Tellzies/ChairSpeaker-CS4S-Batch2/Hardware/CS4S/Fabrication/Report Board Stack/Chairspeaker TI Receiver REV1-1.xls

Board Stack Report
Stack Up |  | Layer Stack
Layer | Board Layer Stack | Name | Material | Thickness | Constant
1 |  | Top Paste
2 |  | Top Overlay
3 |  | Top Solder | Solder Resist | 0.40mil | 3.5
4 |  | Top Layer | Copper | 0.71mil
5 |  | Dielectric1 | FR-4 | 60.79mil | 4.2
6 |  | Bot Layer | Copper | 0.71mil
7 |  | Bottom Solder | Solder Resist | 0.40mil | 3.5
8 |  | Bottom Overlay
9 |  | Bottom Paste
 | Height : 63.01mil
