Tellzies/ChairSpeaker-CS4S-Batch2/Software/doc/bone conductor eq.png

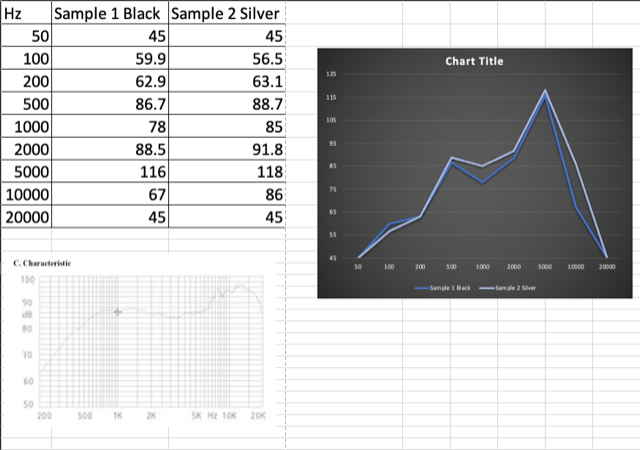
Software/doc/bone conductor eq.png
