Tellzies/ChairSpeaker-CS4S-Batch2/Hardware/CS4S/BOM/PROTO/BOM-Chairspeaker TI Receiver REV1-1_PROTO.xlsx

Quantity | Designator | Fitted | Value | Description1 | Manufacturer 1 | Manufacturer Part Number 1 | Cross Allowed
3 | BT1, J3, J4 | Fitted | 0530470210 | CONN HEADER VERT 2POS 1.25MM | Molex | 0530470210 | YES
17 | C1, C2, C7, C8, C12, C25, C30, C37, C42, C46, C48, C52, C55, C62, C69, C70, C71 | Fitted | 1uF/10V | CAP CER 1UF 10V X5R 0402 | Murata Electronics | GRM155R61A105KE15D | YES
3 | C3, C56, C57 | Fitted | 47pF/50V | CAP CER 47PF 50V C0G/NPO 0402 | Yageo | CC0402JRNPO9BN470 | YES
25 | C4, C6, C10, C13, C14, C15, C16, C17, C18, C19, C20, C22, C26, C31, C34, C35, C38, C41, C43, C45, C47, C53, C58, C59, C78 | Fitted | 0.1uF/10V | CAP CER 0.1UF 10V X7R 0402 | Yageo | CC0402KRX7R6BB104 | YES
1 | C5 | Fitted | 100uF/10V | CAP CER 100UF 10V X5R 20% 1210 | Samsung Electro-Mechanics | CL32A107MPVNNNE | YES
1 | C9 | Fitted | 18pF/50V | CAP CER 18PF 50V C0G/NP0 0402 | Samsung Electro-Mechanics | CL05C180JB5NNNC | YES
1 | C11 | Fitted | 1000pF/2KV | CAP CER 1000PF 2KV X7R 1206 | KEMET | C1206C102KGRACTU | YES
1 | C21 | Fitted | 220pF/10V | CAP CER 220PF 10V C0G/NP0 0402 | Würth Elektronik | 885012005015 | YES
3 | C23, C24, C27 | Fitted | 1nF/10V | CAP CER 10000PF 10V X7R 0402 | Yageo | CC0402KRX7R6BB103 | YES
0 | C28, C29 | Not Fitted | 1pF/50V | CAP CER 1PF 50V NP0 0402 | AVX Corporation | 04025A1R0KAT2A | YES
2 | C32, C33 | Fitted | 12pF/25V | CAP CER 12PF 25V C0G/NP0 0402 | Walsin Technology Corporation | 0402N120J250CT | YES
3 | C36, C49, C61 | Fitted | 10uF/10V | CAP CER 10UF 10V X5R 0805 | Samsung Electro-Mechanics | CL21A106KPFNNNG | YES
4 | C39, C51, C63, C68 | Fitted | 39pF/50V | CAP CER 39PF 50V C0G/NP0 0402 | Samsung Electro-Mechanics | CL05C390JB5NNNC | YES
4 | C40, C44, C64, C66 | Fitted | 330pF/50V | CAP CER 330PF 50V C0G/NP0 0402 | Walsin Technology Corporation | 0402N331J500CT | YES
0 | C50, C67 | Not Fitted | 390pF/50V | CAP CER 390PF 50V X7R 0402 | AVX Corporation | 04025C391JAT2A | YES
1 | C54 | Fitted | 6.8pF/50V | CAP CER 6.8PF 50V C0G/NP0 0402 | Samsung Electro-Mechanics | 04025A6R8KAT2A | YES
1 | C60 | Fitted | 1pF/50V | CAP CER 1PF 50V NP0 0402 | AVX Corporation | 04025A1R0KAT2A | YES
1 | C65 | Fitted | 1.8pF/50V | CAP CER 1.8PF 50V C0G/NP0 0402 | Samsung Electro-Mechanics | CL05C1R8BB5NNNC | YES
0 | C77 | Not Fitted | 0.1uF/10V | CAP CER 0.1UF 10V X7R 0402 | Yageo | CC0402KRX7R6BB104 | YES
0 | CLP1, CLP2, CLP3 | Not Fitted | S1001-46R | RFI SHIELD CLIP MICRO TIN SMD | Harwin Inc. | S1001-46R | NO
2 | D1, D3 | Fitted | SMAJ7.0CA | TVS DIODE 7VWM 12VC SMA | Littlefuse | SMAJ7.0CA | NO
2 | D2, D9 | Fitted | NSR0320MW2T3G | DIODE SCHOTTKY 20V 1A SOD323 | ON Semiconductor | NSR0320MW2T3G | NO
1 | D4 | Fitted | ESD9B5.0ST5G | TVS DIODE 5V SOD923 | ON Semiconductor | ESD9B5.0ST5G | NO
0 | D5, D10 | Not Fitted | ESD9B3.3ST5G | TVS DIODE 3.3V 11.5V SOD923 | ON Semiconductor | ESD9B3.3ST5G | YES
0 | D6, D7, D11 | Not Fitted | GG0402050R3C2P | TVS DIODE 5V 15.5V 0402 | AVX Corporation | GG0402050R3C2P | YES
0 | D8 | Not Fitted | NSR0320MW2T3G | DIODE SCHOTTKY 20V 1A SOD323 | ON Semiconductor | NSR0320MW2T3G | NO
0 | DM1 | Not Fitted | DM-SHIELD | TBD | TBD | TBD | NO
3 | FB1, FB2, FB3 | Fitted | BK1005HS102-T | FERRITE BEAD 1 KOHM 0402 1LN | Taiyo Yuden | BK1005HS102-T | YES
1 | J1 | Fitted | ZX62-B-5PA(33) | CONN RCPT MICRO USB B SMD R/A | Hirose | ZX62-B-5PA(33) | YES
0 | J5 | Not Fitted | HDR_1X2 | CONN HEADER VERT 2POS 2.54MM | Harwin Inc. | M20-9990246 | YES
1 | L1 | Fitted | MPZ1608S300ATAH0 | FERRITE BEAD 30 OHM 0603 1LN | TDK Corporation | MPZ1608S300ATAH0 | YES
9 | L2, L3, L7, L8, L9, L10, L11, L12, L14 | Fitted | 6.8nH | FIXED IND 6.8NH 430MA 250 MOHM | Taiyo Yuden | HK10056N8J-T | YES
1 | L4 | Fitted | 2.2nH | FIXED IND 2.2NH 900MA 120MOHM SM | Murata Electronics | LQG15HS2N2S02D | YES
1 | L5 | Fitted | 3nH | FIXED IND 3NH 800MA 125 MOHM SMD | Murata Electronics | LQG15HS3N0S02D | YES
1 | L6 | Fitted | 3.9nH | FIXED IND 3.9NH 750MA 180MOHM SM | Murata Electronics | LQG15HS3N9S02D | YES
3 | L13, L15, L16 | Fitted | BLM18PG121SN1D | FERRITE BEAD 120 OHM 0603 1LN | Murata | BLM18PG121SN1D | YES
1 | L17 | Fitted | 1.5nH | FIXED IND 1.5NH 1A 100 MOHM SMD | Murata Electronics | LQG15HS1N5S02D | YES
2 | LED1, LED2 | Fitted | LTST-C193TBKT-5A | LED BLUE CLEAR CHIP 0603 SMD | LITEON | LTST-C193TBKT-5A | YES
0 | P1 | Not Fitted | TC2050-IDC-NL | PROGRAMMING CABLE PLUG-OF-NAILS | TAG-CONNECT | TC2050-IDC-NL | NO
8 | R1, R4, R10, R13, R18, R27, R33, R43 | Fitted | 10K | RES 10K OHM 1% 1/16W 0402 | Stackpole Electronics Inc | RMCF0402FT10K0 | YES
0 | R2, R7 | Not Fitted | 0R/1.5W | RES SMD 0 OHM JUMPER 1.5W 2512 | Vishay Dale | CRCW25120000Z0EGHP | YES
8 | R3, R6, R29, R30, R32, R38, R40, R42 | Fitted | 0R | RES 0R JUMPER 1/10W 0402 | Panasonic Electronic Components | ERJ-2GE0R00X | YES
1 | R5 | Fitted | 2K | RES SMD 2K OHM 1% 1/10W 0402 | Panasonic | ERJ-2RKF2001X | YES
0 | R8, R9, R15 | Not Fitted | 0R | RES 0R JUMPER 1/10W 0402 | Panasonic Electronic Components | ERJ-2GE0R00X | YES
1 | R11 | Fitted | 4.3K | RES 4.3K OHM 1% 1/10W 0402 | KOA Speer Electronics, Inc. | RK73H1ETTP4301F | YES
0 | R12, R20, R35, R45 | Not Fitted | 10K | RES 10K OHM 1% 1/16W 0402 | Stackpole Electronics Inc | RMCF0402FT10K0 | YES
1 | R14 | Fitted | 1M | RES SMD 1M OHM 1% 1/10W 0402 | Panasonic | ERJ-2RKF1004X | YES
1 | R17 | Fitted | 56K | RES 56K OHM 1% 1/16W 0402 | Stackpole Electronics Inc | RMCF0402FT56K0 | YES
1 | R19 | Fitted | 100K | RES 100K OHM 1% 1/16W 0402 | Stackpole Electronics Inc | RMCF0402FT100K | YES
1 | R21 | Fitted | 470R | RES 470 OHM 1% 1/16W 0402 | Stackpole Electronics Inc | RMCF0402FT470R | YES
1 | R22 | Fitted | 220R | RES 220 OHM 1% 1/16W 0402 | Stackpole Electronics Inc | RMCF0402FT220R | YES
4 | R28, R31, R39, R41 | Fitted | 30K | RES SMD 30K OHM 1% 1/10W 0402 | Panasonic Electronic Components | ERJ-2RKF3002X | YES
2 | R34, R44 | Fitted | 1K | RES 1K OHM 1% 1/16W 0402 | Stackpole Electronics Inc | RMCF0402FT1K00 | YES
2 | R36, R37 | Fitted | 4.7K | RES 4.7K OHM 1% 1/16W 0402 | Stackpole Electronics Inc | RMCF0402FT4K70 | YES
1 | S1 | Fitted | RV0971GS | Potentiometer |  | RV0971GS | YES
1 | SW1 | Fitted | PTS645-V-L58-2-LFS | SWITCH TACTILE SPST-NO 0.05A 12V | C&K | PTS645-V-L58-2-LFS | YES
1 | U1 | Fitted | BU33SD5WG-TR | IC REG LINEAR 3.3V 500MA 5SSOP | Rohm Semiconductor | BU33SD5WG-TR | NO
1 | U2 | Fitted | MCP73812T-420I/OT | CHARGER IC LI-ION/LI-POLY SOT23-5 | MICROCHIP | MCP73812T-420I/OT | NO
1 | U3 | Fitted | CC8530RHAT | RF Transceiver PurePath Wireless 2.4GHz RF SoC | Texas Instruments | CC8530RHAT | NO
0 | U4 | Not Fitted | PESD3V3L5UY,115 | TVS DIODE 3.3V 12V 6TSSOP | Nexperia USA Inc. | PESD3V3L5UY,115 | NO
2 | U5, U7 | Fitted | NS4150 | Low EMI,Filterless,3W Mono Class D Audio Amplifier, Low EMI,Filterless,3W Mono Class D Audio Amplifier,SOP-8 | NSIWAY | NS4150 | NO
1 | U6 | Fitted | TLV320DAC32IRHBR | IC DAC 24BIT 96K 32VQFN | Texas Instruments | TLV320DAC32IRHBR | NO
1 | U8 | Fitted | Value | IC RF FRONT END 2.4GHZ 16-QFN
1 | X1 | Fitted | 48MHz | CRYSTAL 48.0000MHZ 10PF SMD | ECS Inc. | ECS-480-10-36B-CKM-TR | NO
