Tellzies/ChairSpeaker-CS4S-Batch2/Hardware/CS4S/DOCUMENTATION/PROTO/Chairspeaker TI Receiver REV1-1 Schematic 2022-04-20.PDF

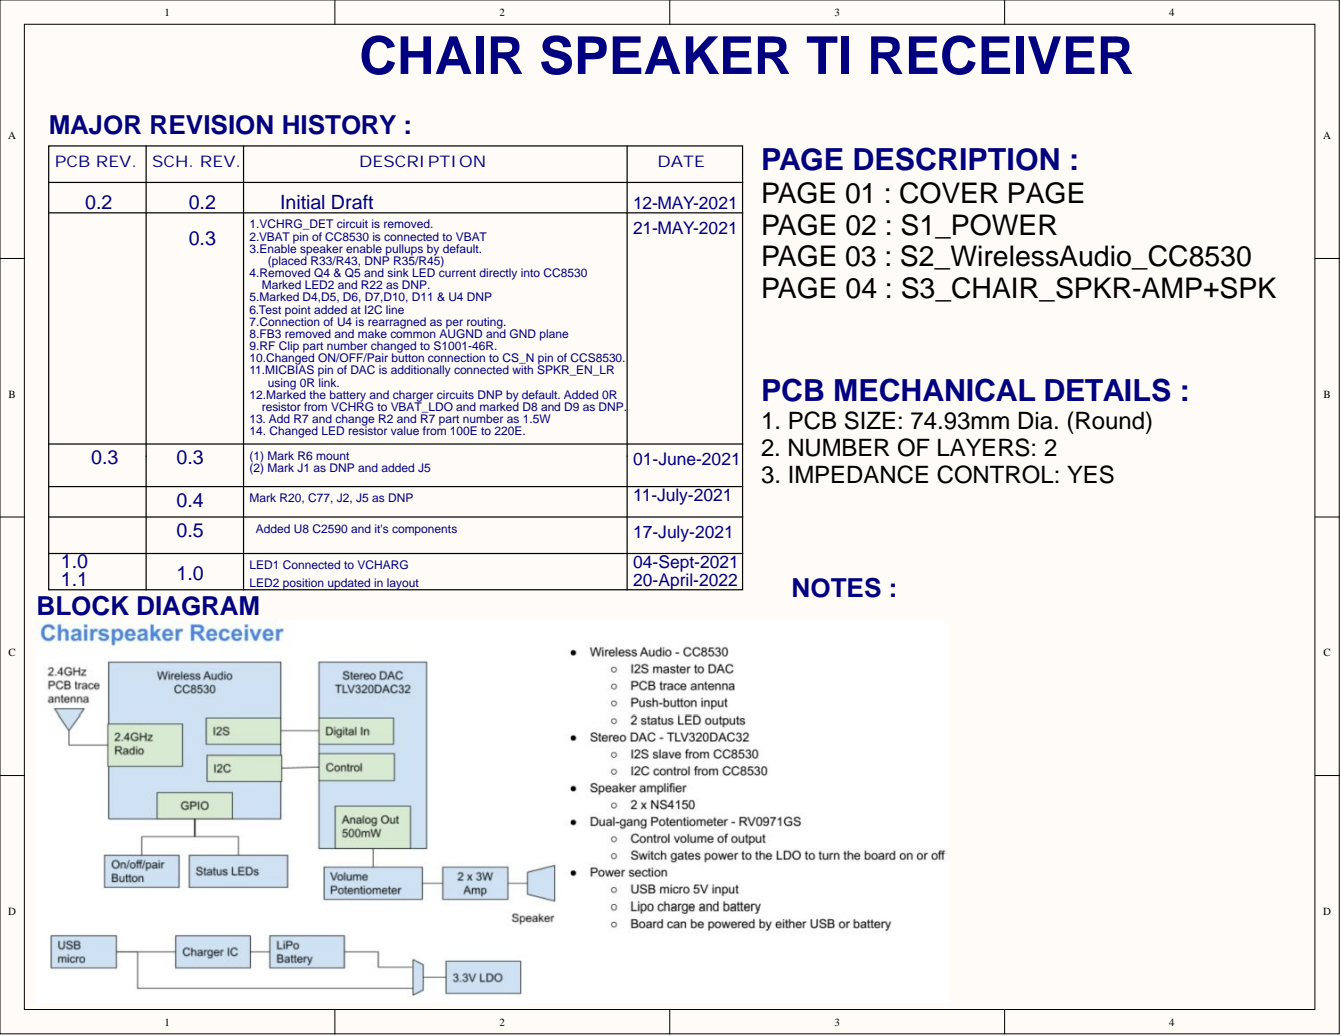
[picture p2: page 1]

CHAIR SPEAKER TI RECEIVER

PCB REV. | SCH. REV. | DESCRIPTION | DATE

0.2 | | Initial Draft | 12-MAY-2021

2.VBAT pin of CC8530 is connected to VBAT
3.Enable speaker enable pullups by default.
(placed R33/R43, DNP R35/R45)
4.Removed Q4 & Q5 and sink LED current directly into CC8530
Marked LED2 and R22 as DNP.
5.Marked D4,D5, D6, D7,D10, D11 & U4 DNP
6.Test point added at I2C line
7.Connection of U4 is rearragned as per routing.
8.FB3 removed and make common AUGND and GND plane
9.RF Clip part number changed to S1001-46R.
10.Changed ON/OFF/Pair button connection to CS_N pin of CCS8530.
11.MICBIAS pin of DAC is additionally connected with SPKR_EN_LR
using 0R link.
12.Marked the battery and charger circuits DNP by default. Added 0R
resistor from VCHRG to VBAT_LDO and marked D8 and D9 as DNP.
13. Add R7 and change R2 and R7 part number as 1.5W
14. Changed LED resistor value from 100E to 220E.

PCB MECHANICAL DETAILS :
1. PCB SIZE: 74.93mm Dia. (Round)
2. NUMBER OF LAYERS: 2
3. IMPEDANCE CONTROL: YES

0.3 | 0.3 | (2) Mark J1 as DNP and added J5 | 01-June-2021 (1) Mark R6 mount

0.4 | Mark R20, C77, J2, J5 as DNP | 11-July-2021

0.5 | | 17-July-2021 Added U8 C2590 and it's components

1.1 | 1.0 | LED1 Connected to VCHARG LED2 position updated in layout | 04-Sept-2021 20-April-2022

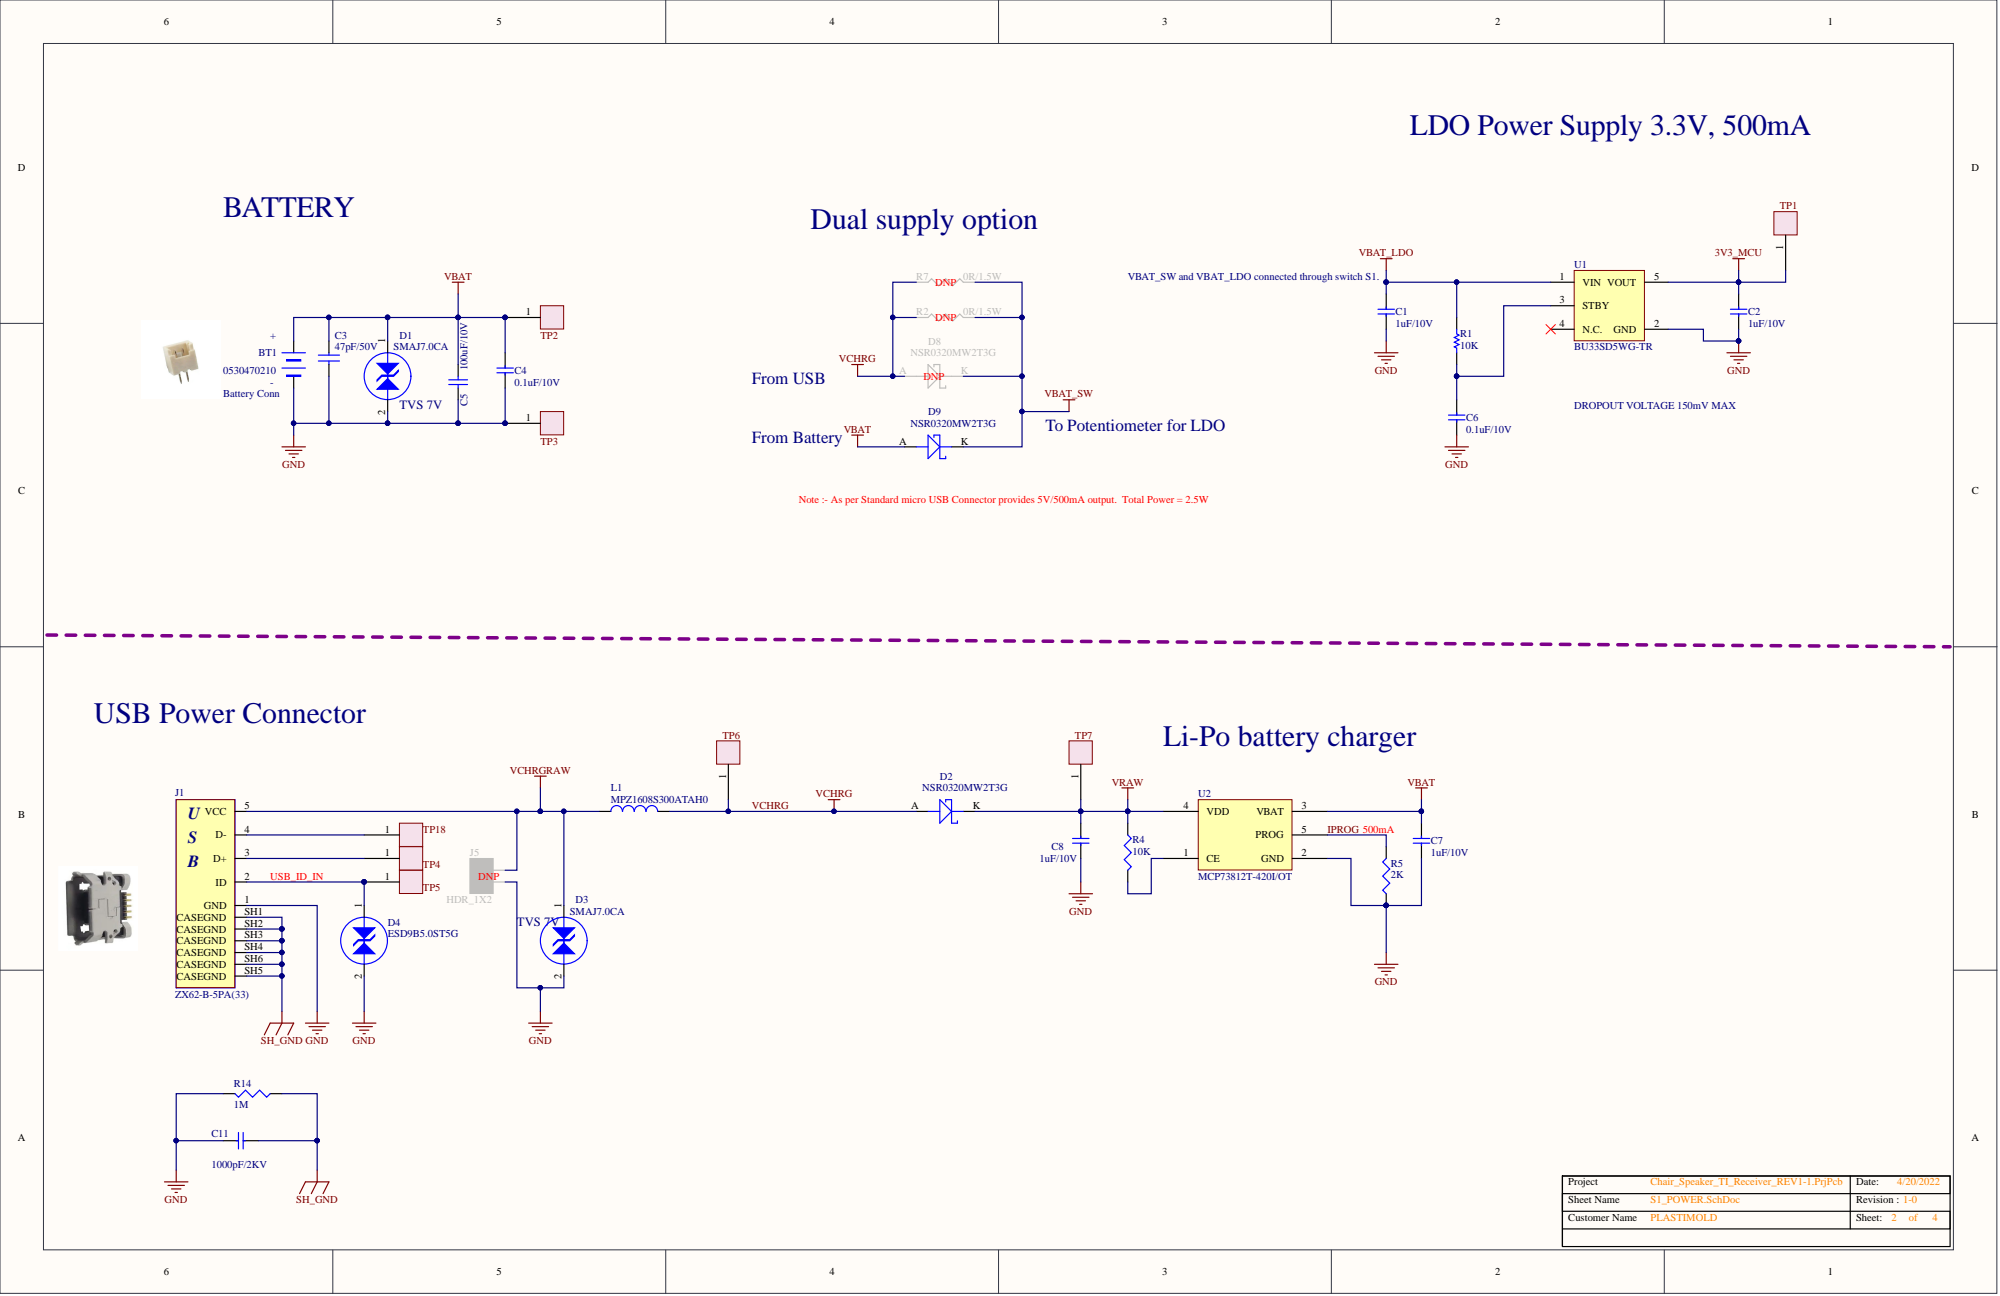
[picture p3: page 2]

VBAT_SW and VBAT_LDO connected through switch S1.

C3 | D1 SMAJ7.0CA

VBAT_SW
To Potentiometer for LDO

Note :- As per Standard micro USB Connector provides 5V/500mA output. Total Power = 2.5W

Li-Po battery charger

Project Chair_Speaker_TI_Receiver_REV1-1.PrjPcb | Date: 4/20/2022
Sheet Name S1_POWER.SchDoc | Revision :
Customer Name PLASTIMOLD | Sheet: 2 of 4

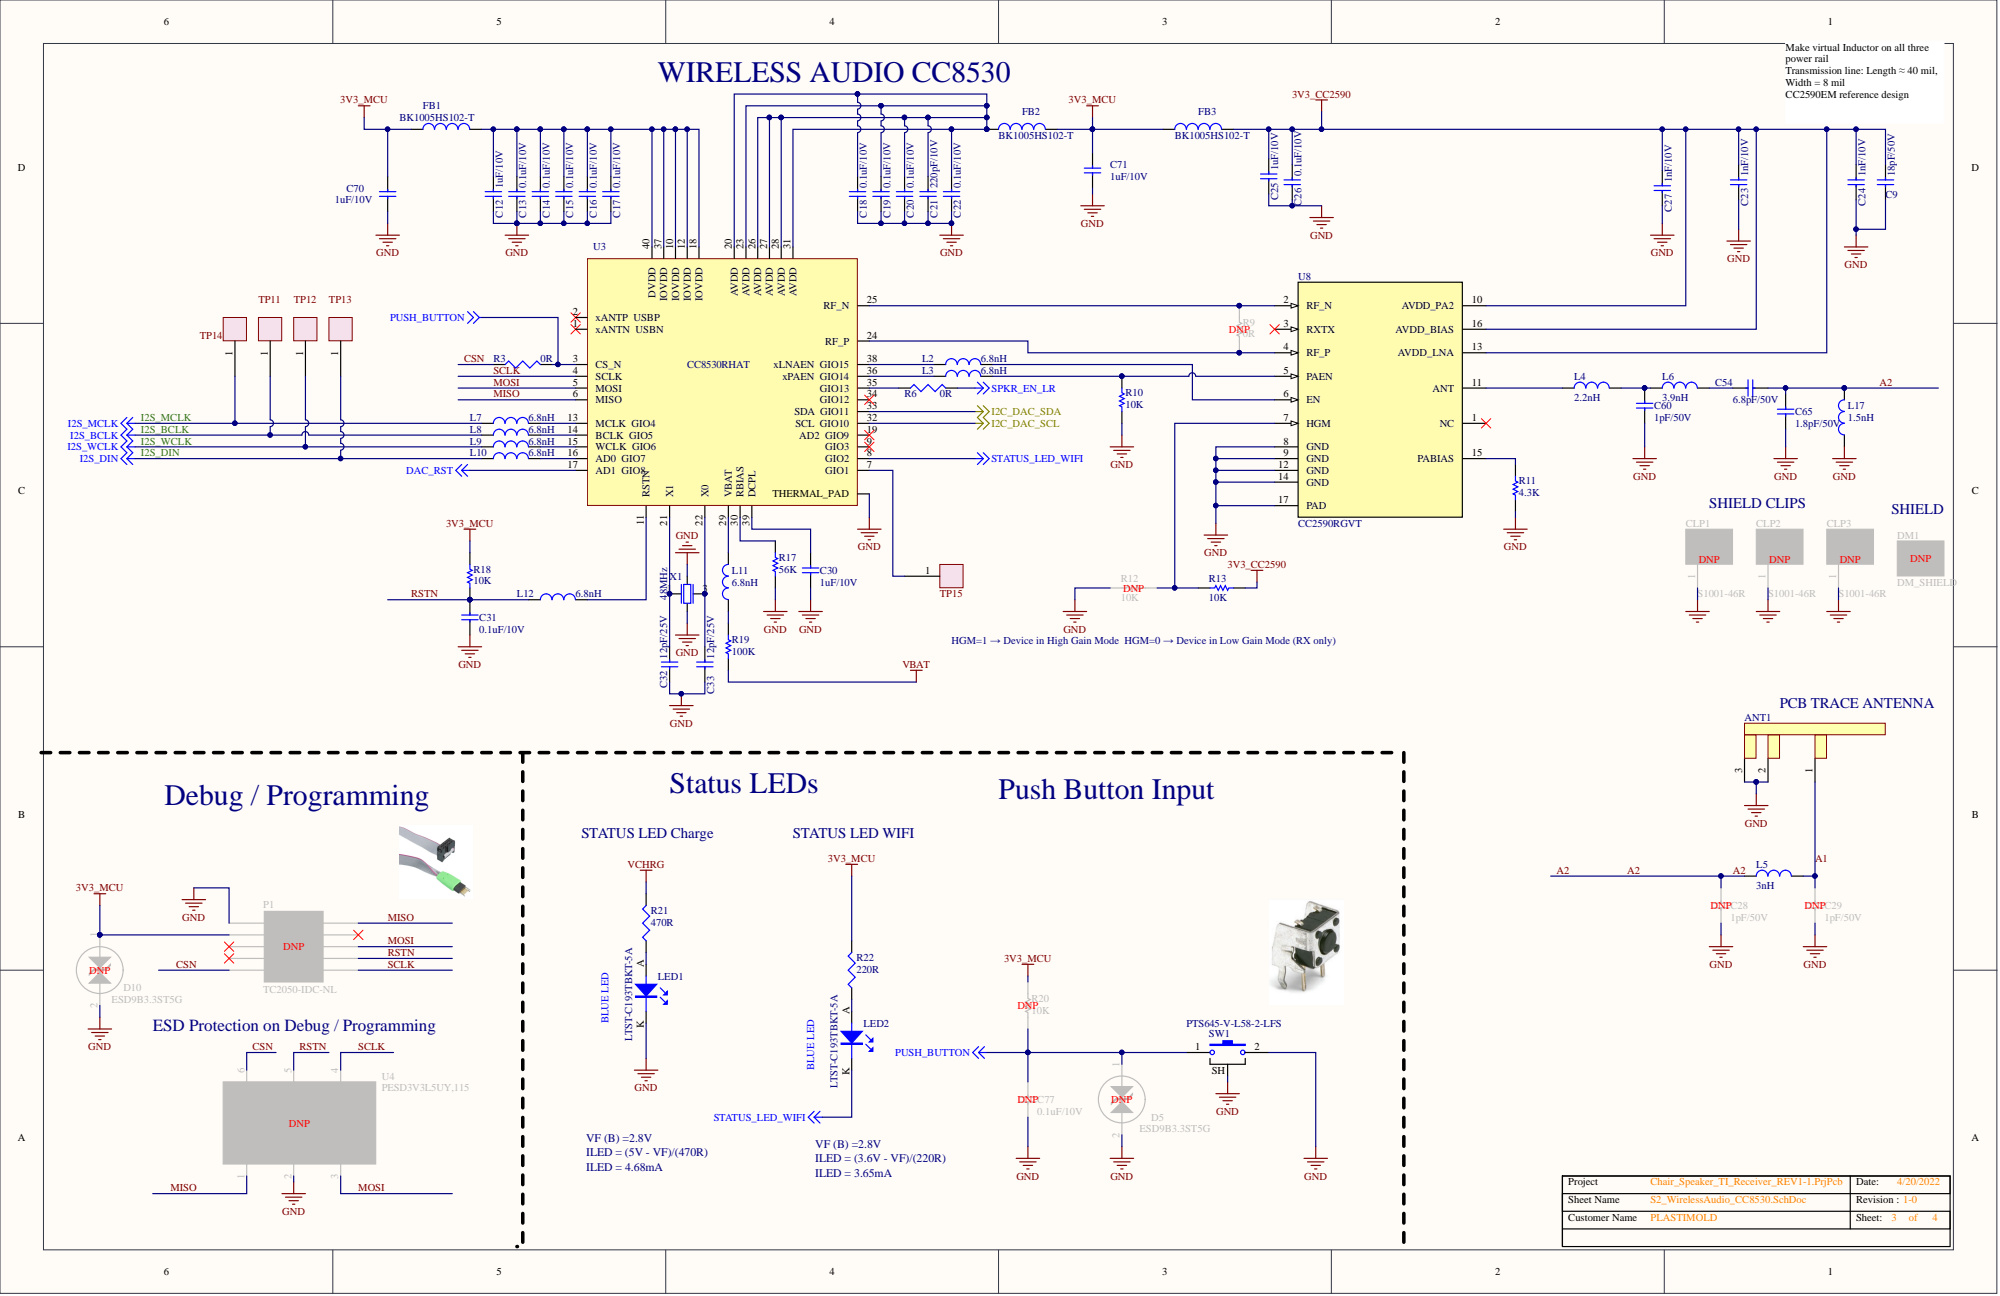
[picture p4: page 3]

Make virtual Inductor on all three
power rail
Transmission line: Length ≈ 40 mil,
Width = 8 mil
CC2590EM reference design

AVDD 31 SCL GIO10 32 SDA GIO11 33 GIO12 34 GIO13 35 xPAEN GIO14 36

GND 8

GND 12
GND 14

PAD 17

GND 1 | 3

HGM=1 → Device in High Gain Mode HGM=0 → Device in Low Gain Mode (RX only)

S2_WirelessAudio_CC8530.SchDoc
PLASTIMOLD | Sheet: 3 of 4

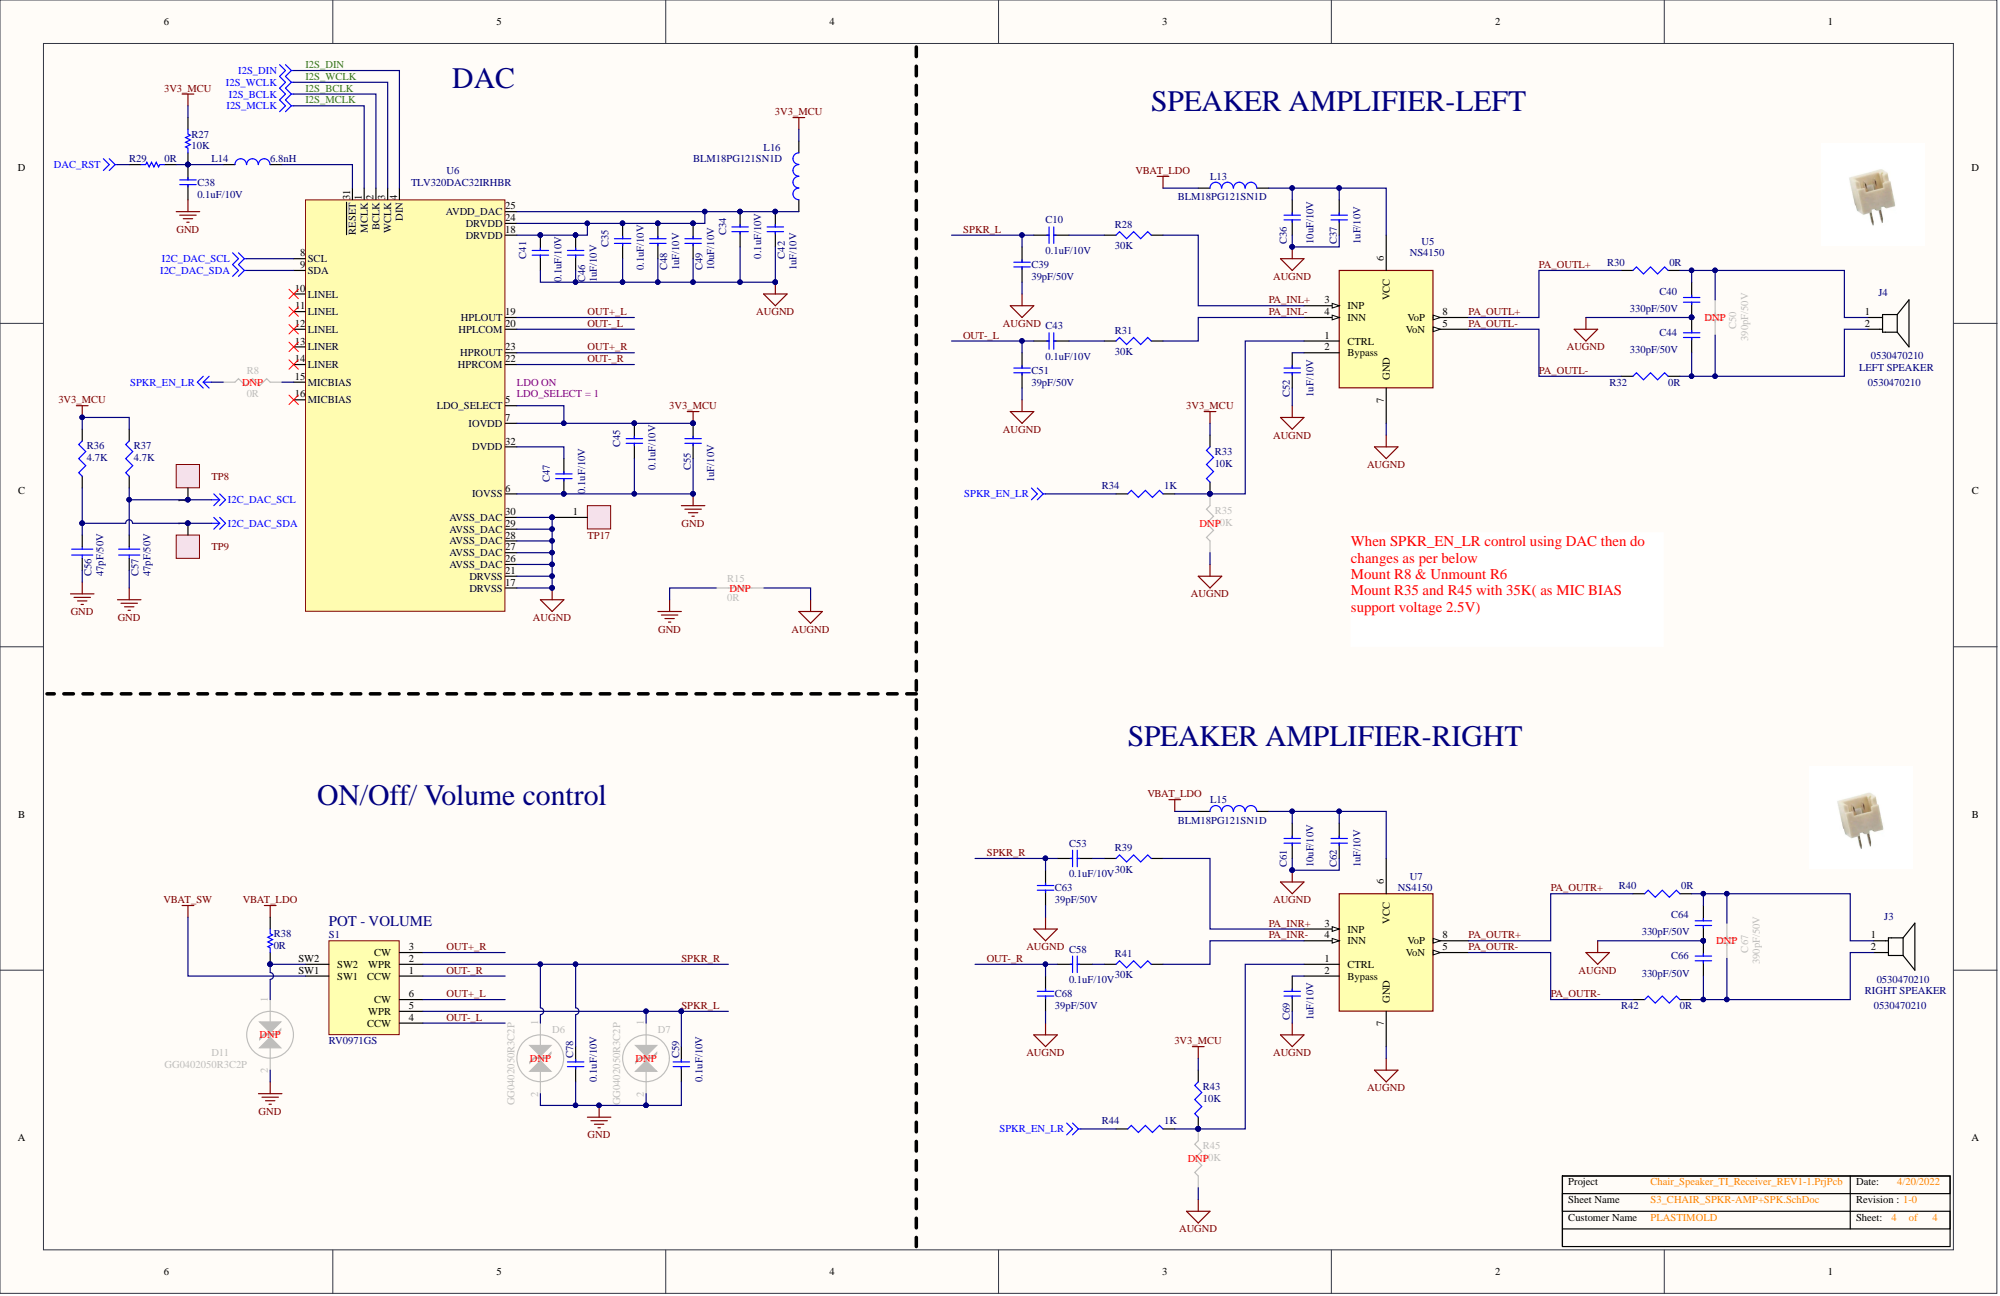
[picture p5: page 4]

When SPKR_EN_LR control using DAC then do
changes as per below
Mount R8 & Unmount R6
Mount R35 and R45 with 35K( as MIC BIAS
support voltage 2.5V)

ON/Off/ Volume control

Project Chair_Speaker_TI_Receiver_REV1-1.PrjPcb | Date: 4/20/2022

S3_CHAIR_SPKR-AMP+SPK.SchDoc
PLASTIMOLD | Sheet: 4 of 4
