Tellzies/ChairSpeaker-CS4S-Batch2/Hardware/CS4S/DOCUMENTATION/PROTO/Chairspeaker TI Receiver REV1-1 Assembly 2022-04-20.PDF

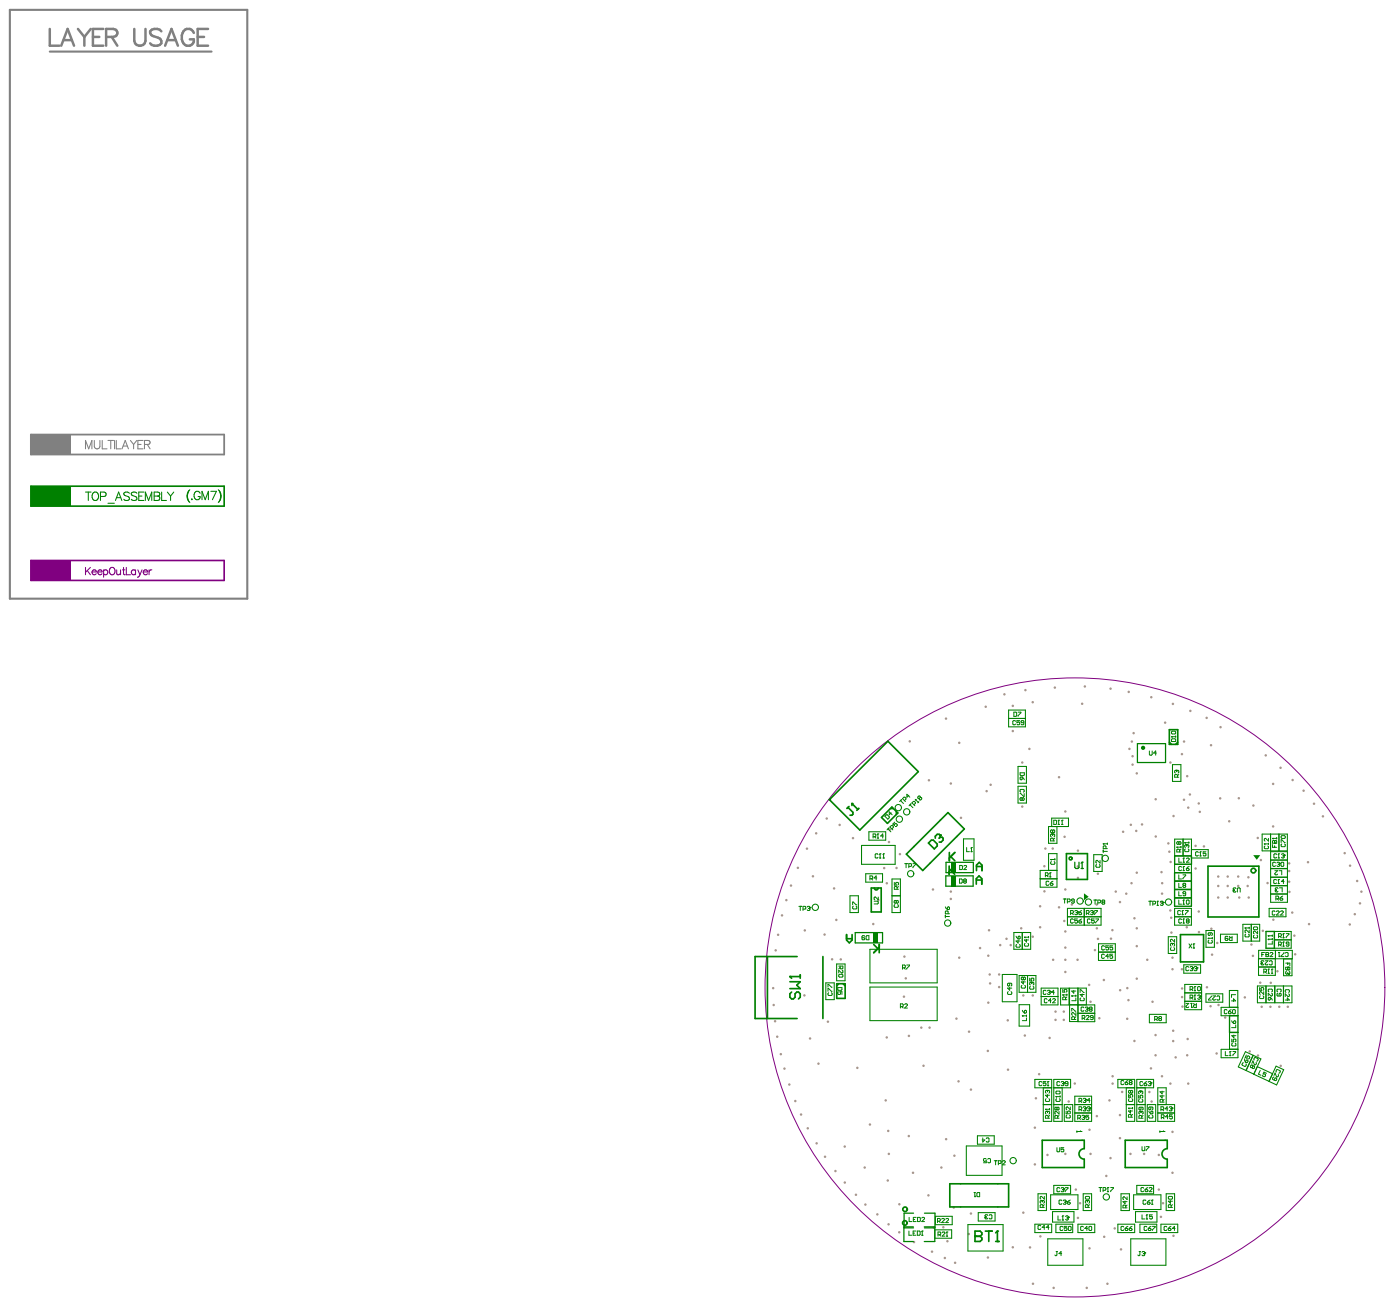
[picture p6: page 1]

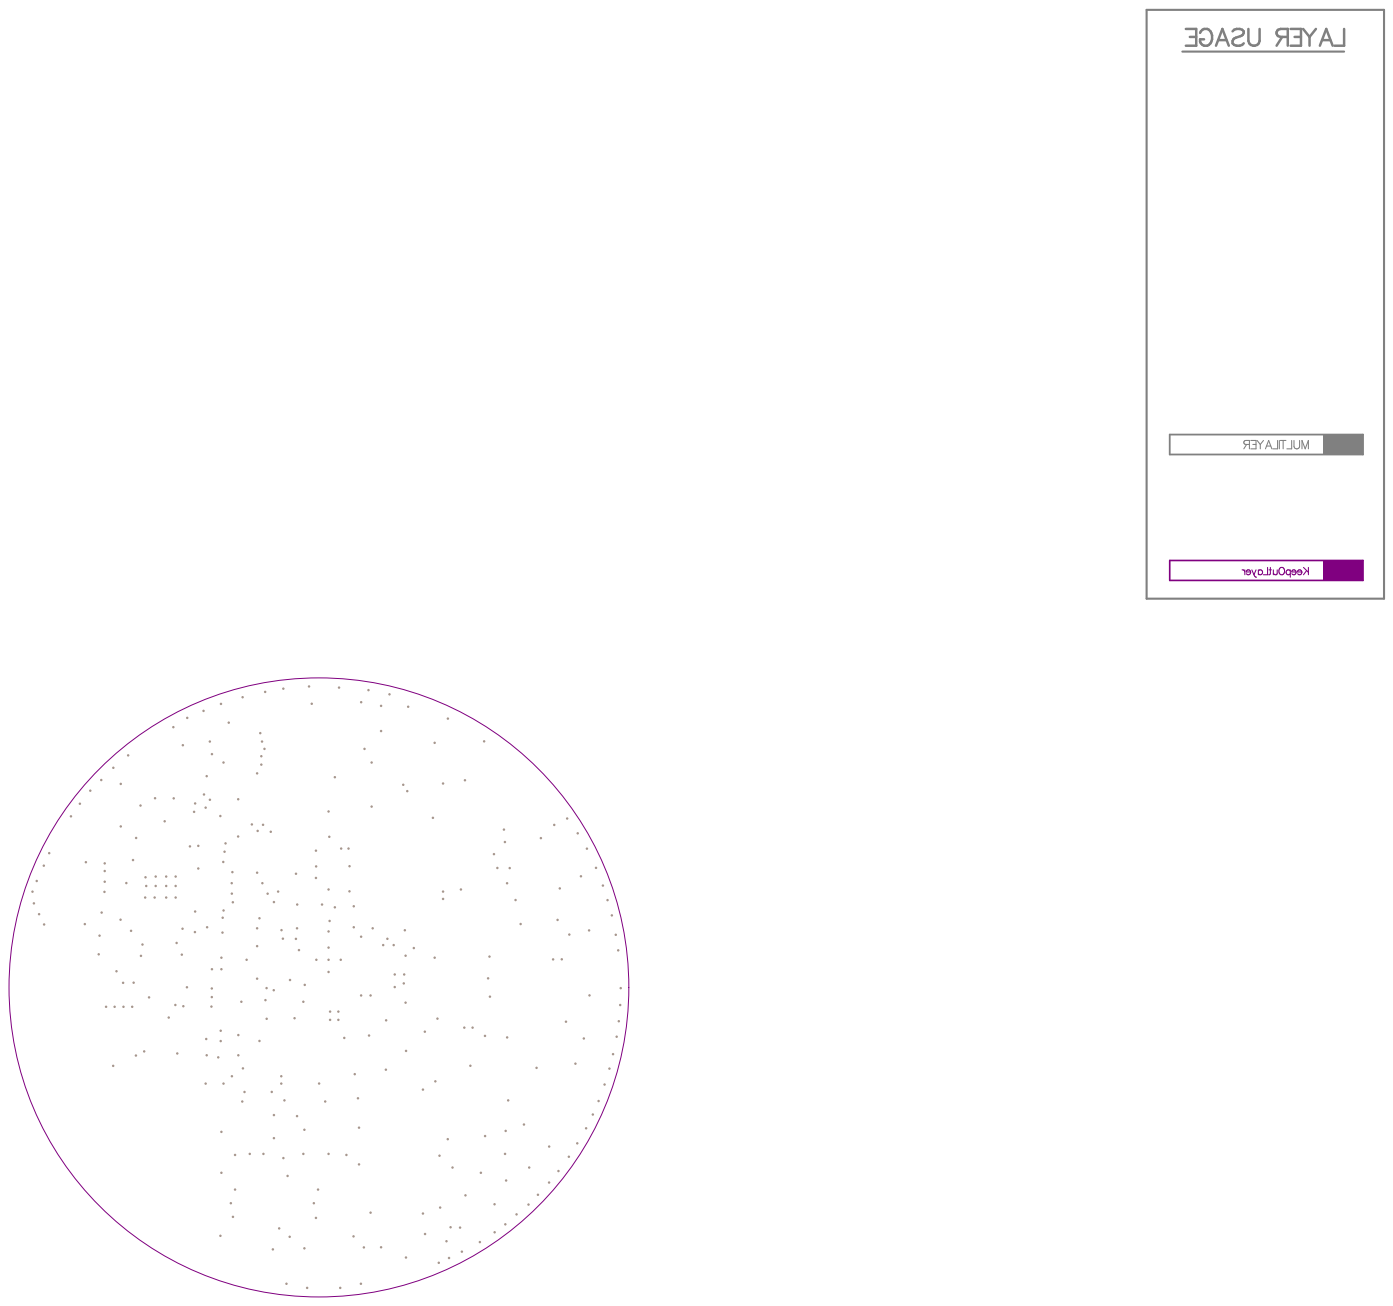
[picture p7: page 2]
