Tellzies/ChairSpeaker-CS4S-Batch2/Hardware/CS4S/DOCUMENTATION/PROTO/Chairspeaker TI Receiver REV1-1 Layout 2022-04-20.PDF

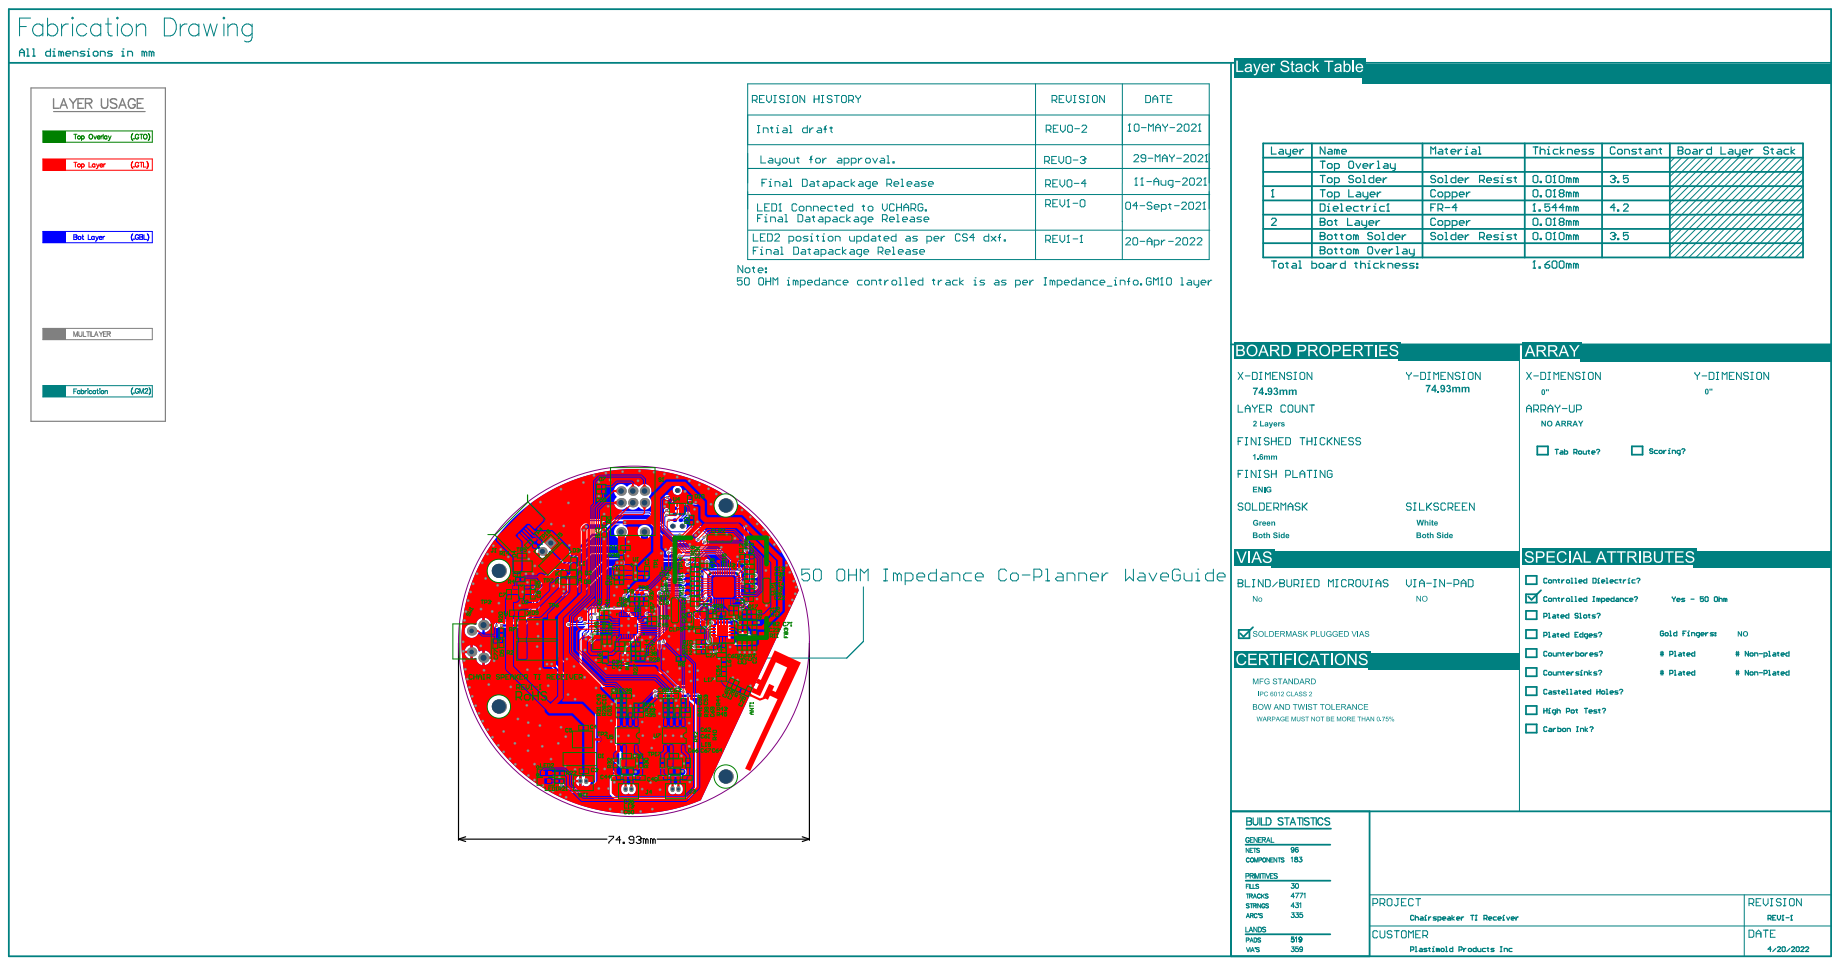
[picture p8: page 1]

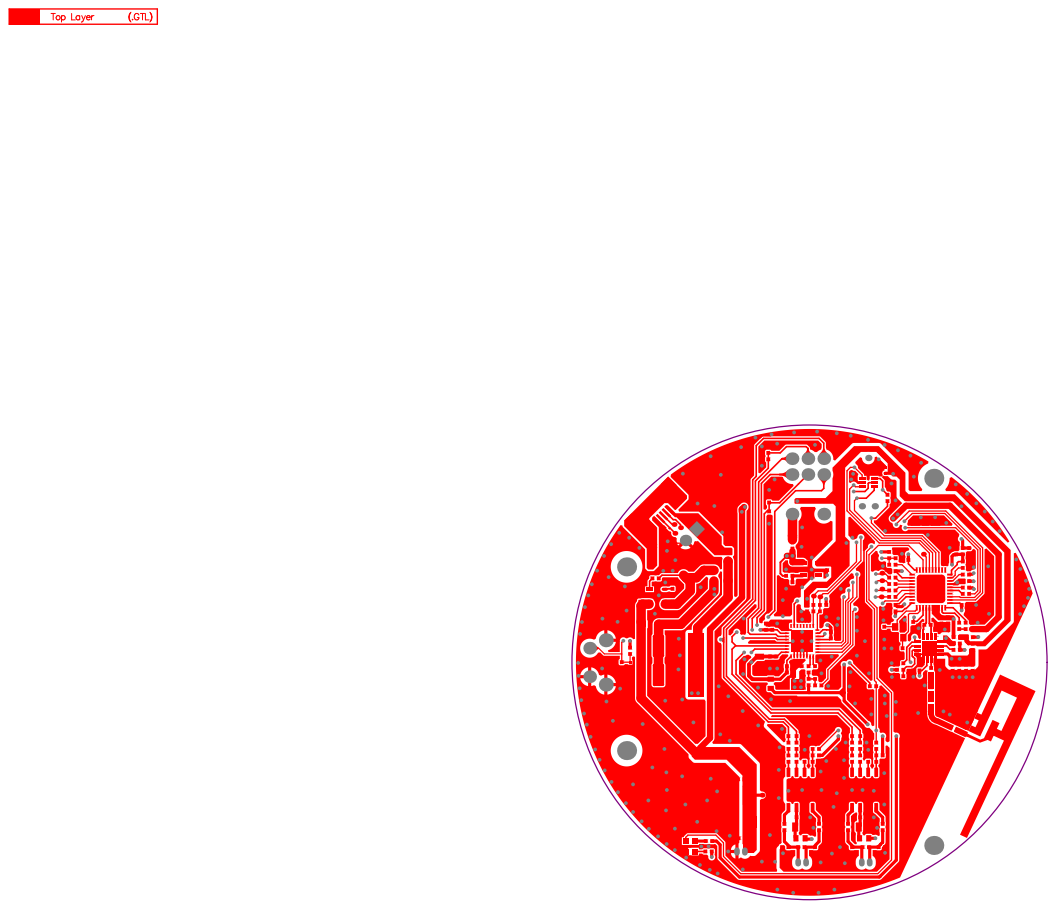
[picture p9: page 2]

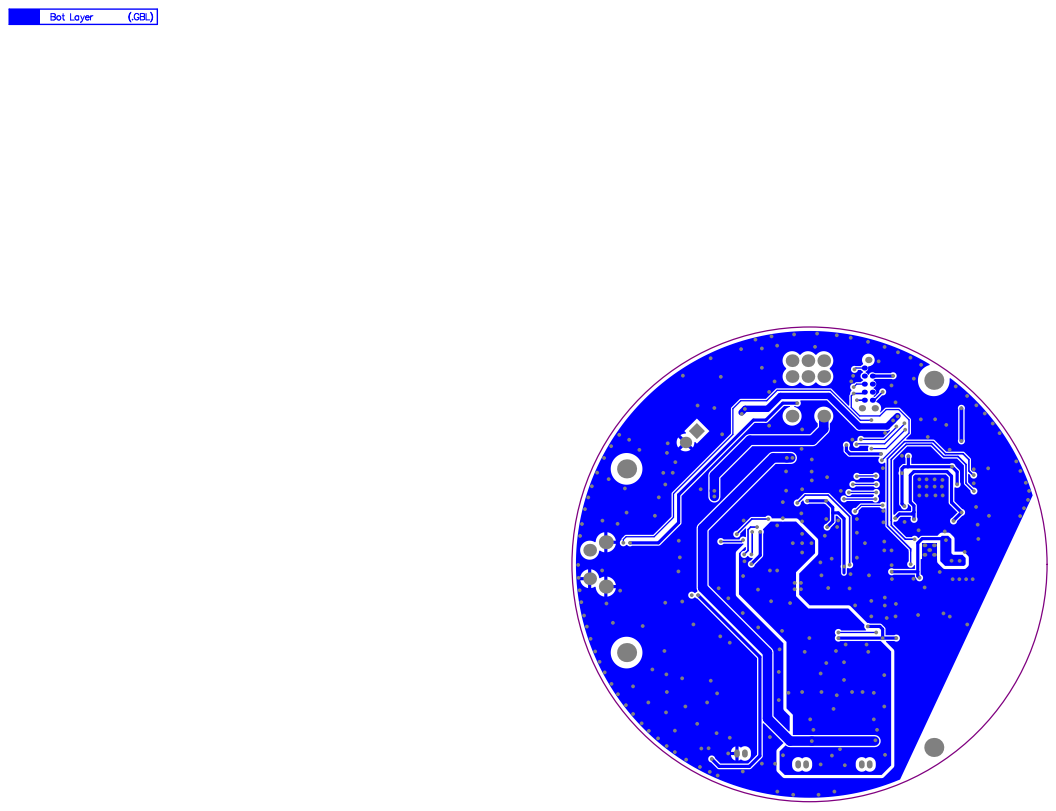
[picture p10: page 5]

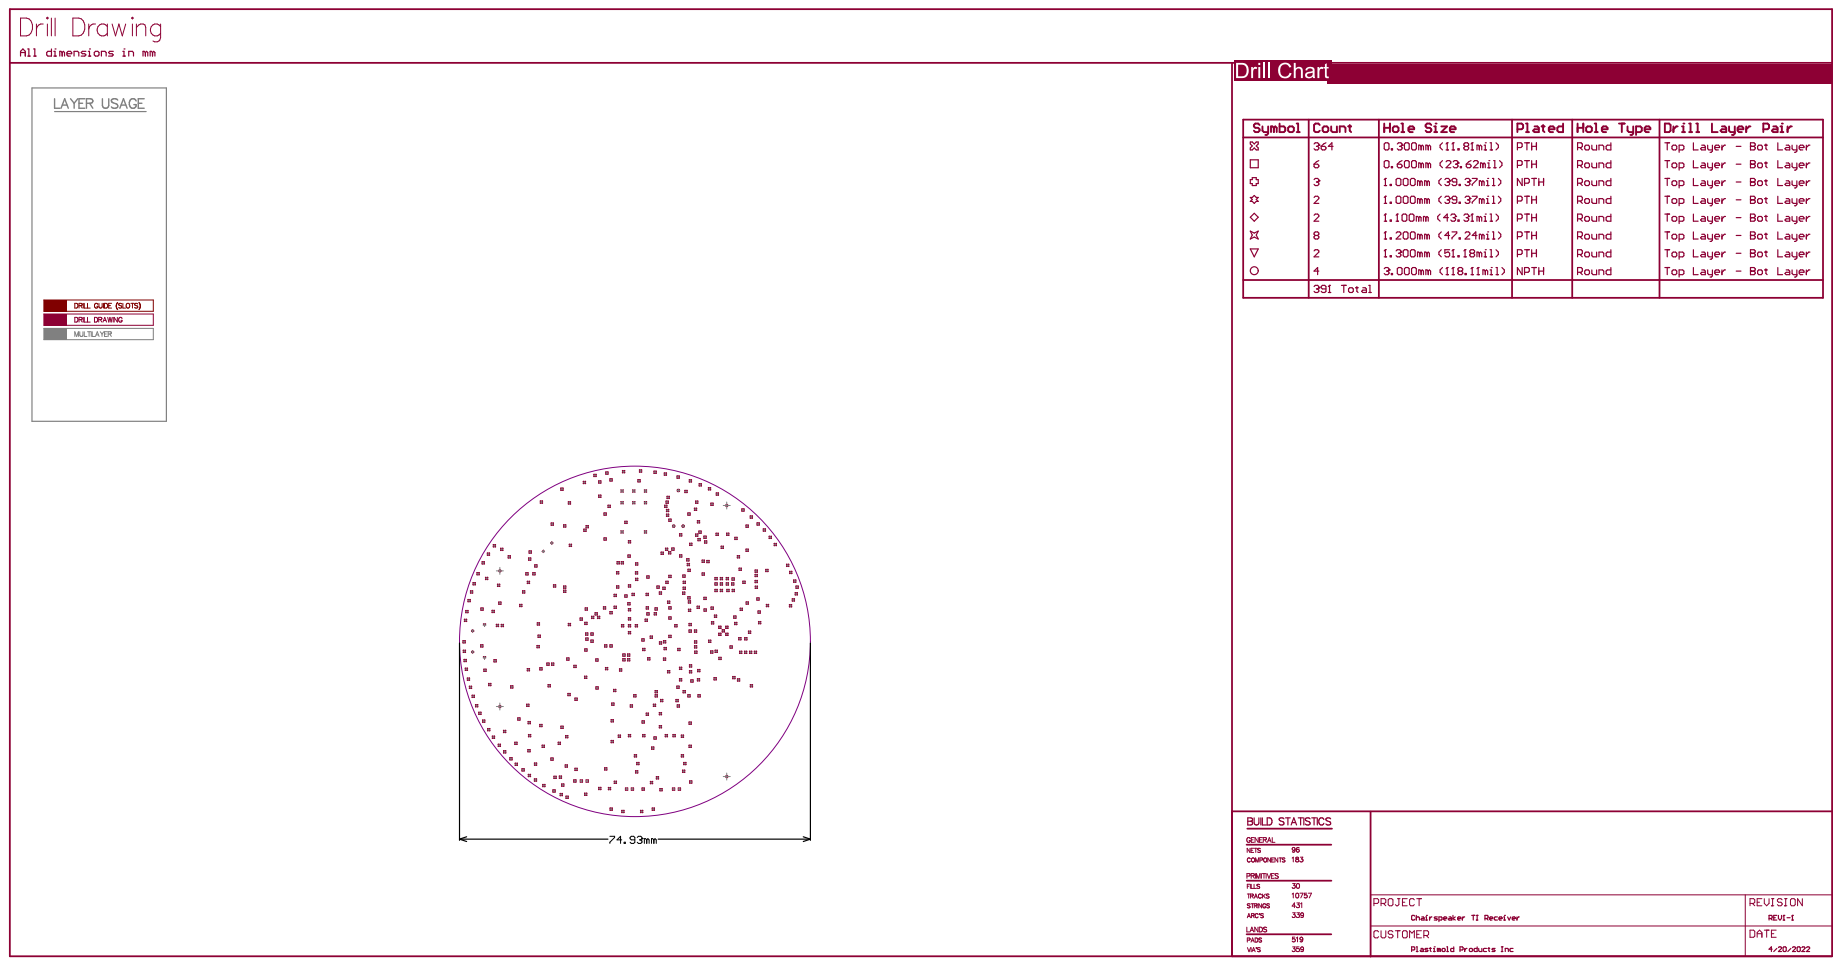
[picture p11: page 6]
