Tellzies/ChairSpeaker-CS4S-Batch2/Hardware/CS4S/DOCUMENTATION/PROTO/Chairspeaker TI Receiver REV1-1 PCB 3D Print Bottom 2022-04-20.PDF

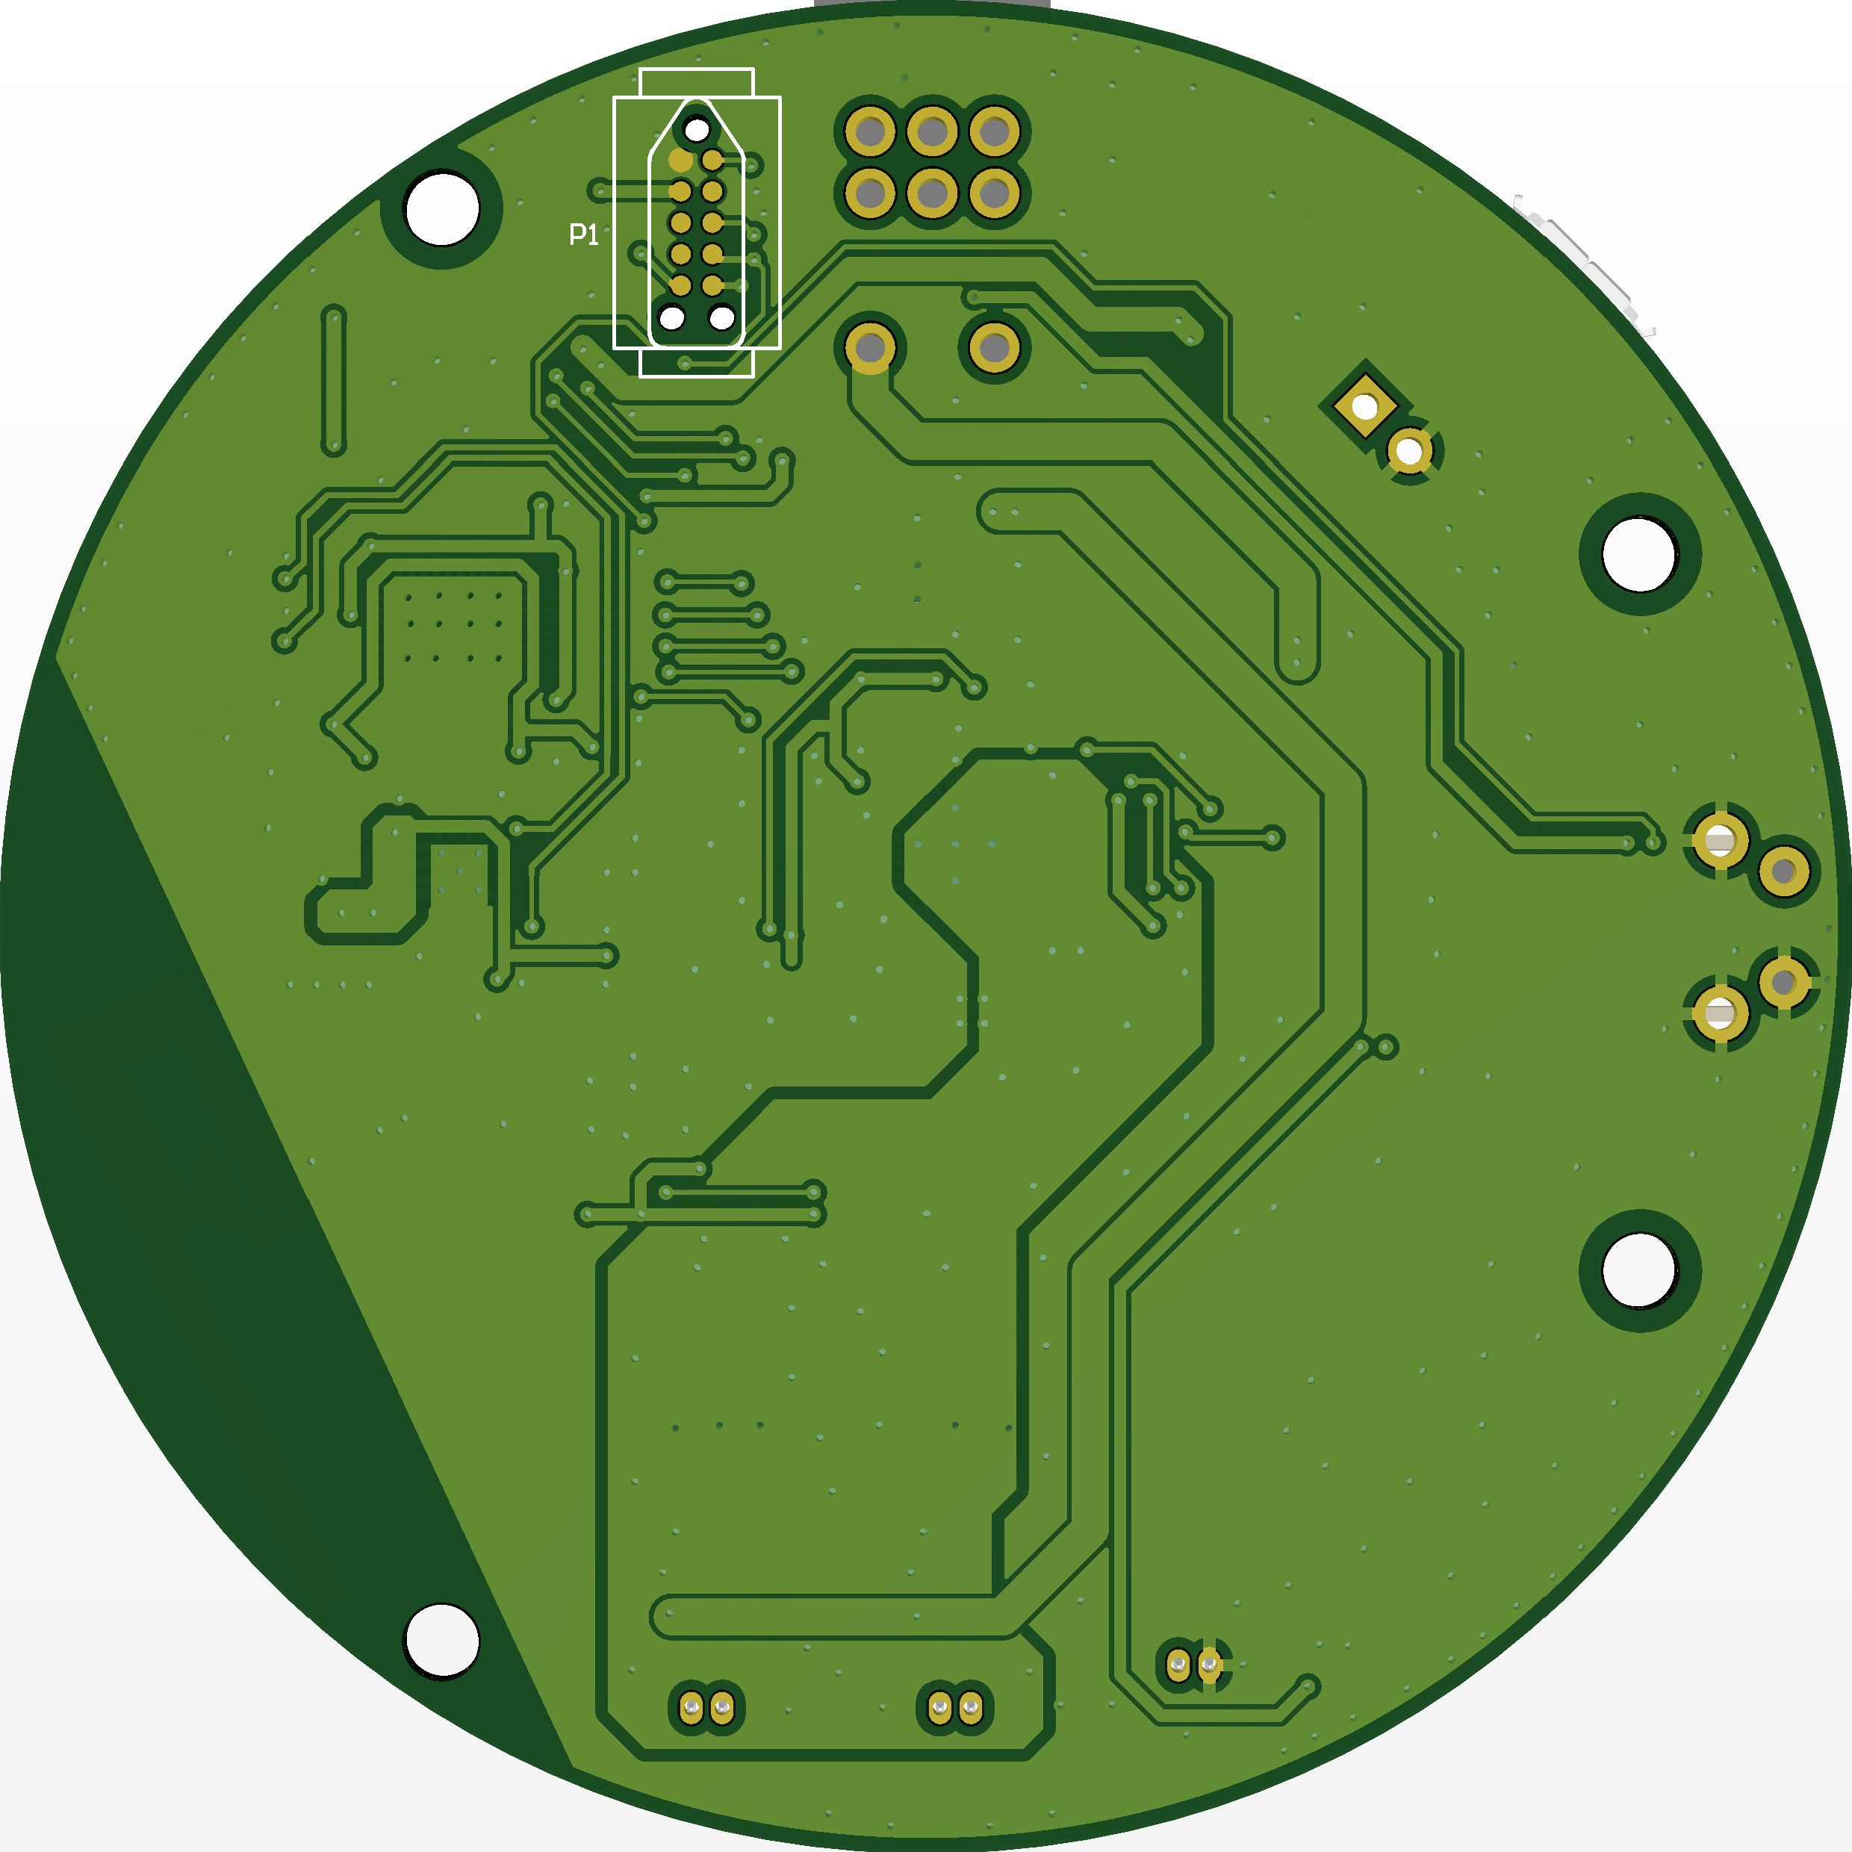
[picture p12: page 1]
