Tellzies/ChairSpeaker-CS4S-Batch2/(list of files, drawings)

Other design files:
Hardware/CS4S/Chair_Speaker_TI_Receiver_REV1-1.PrjPcb
Hardware/CS4S/Schematic/S0_COVER_PAGE.SchDoc
Hardware/CS4S/Schematic/S1_POWER.SchDoc
Hardware/CS4S/Schematic/S2_WirelessAudio_CC8530.SchDoc
Hardware/CS4S/Schematic/S3_CHAIR_SPKR-AMP+SPK.SchDoc
